restelli/current-controller/kicad/CurrentController.kicad_pcb

## KiCad design kicad/CurrentController.kicad_pcb (2024-09-20)

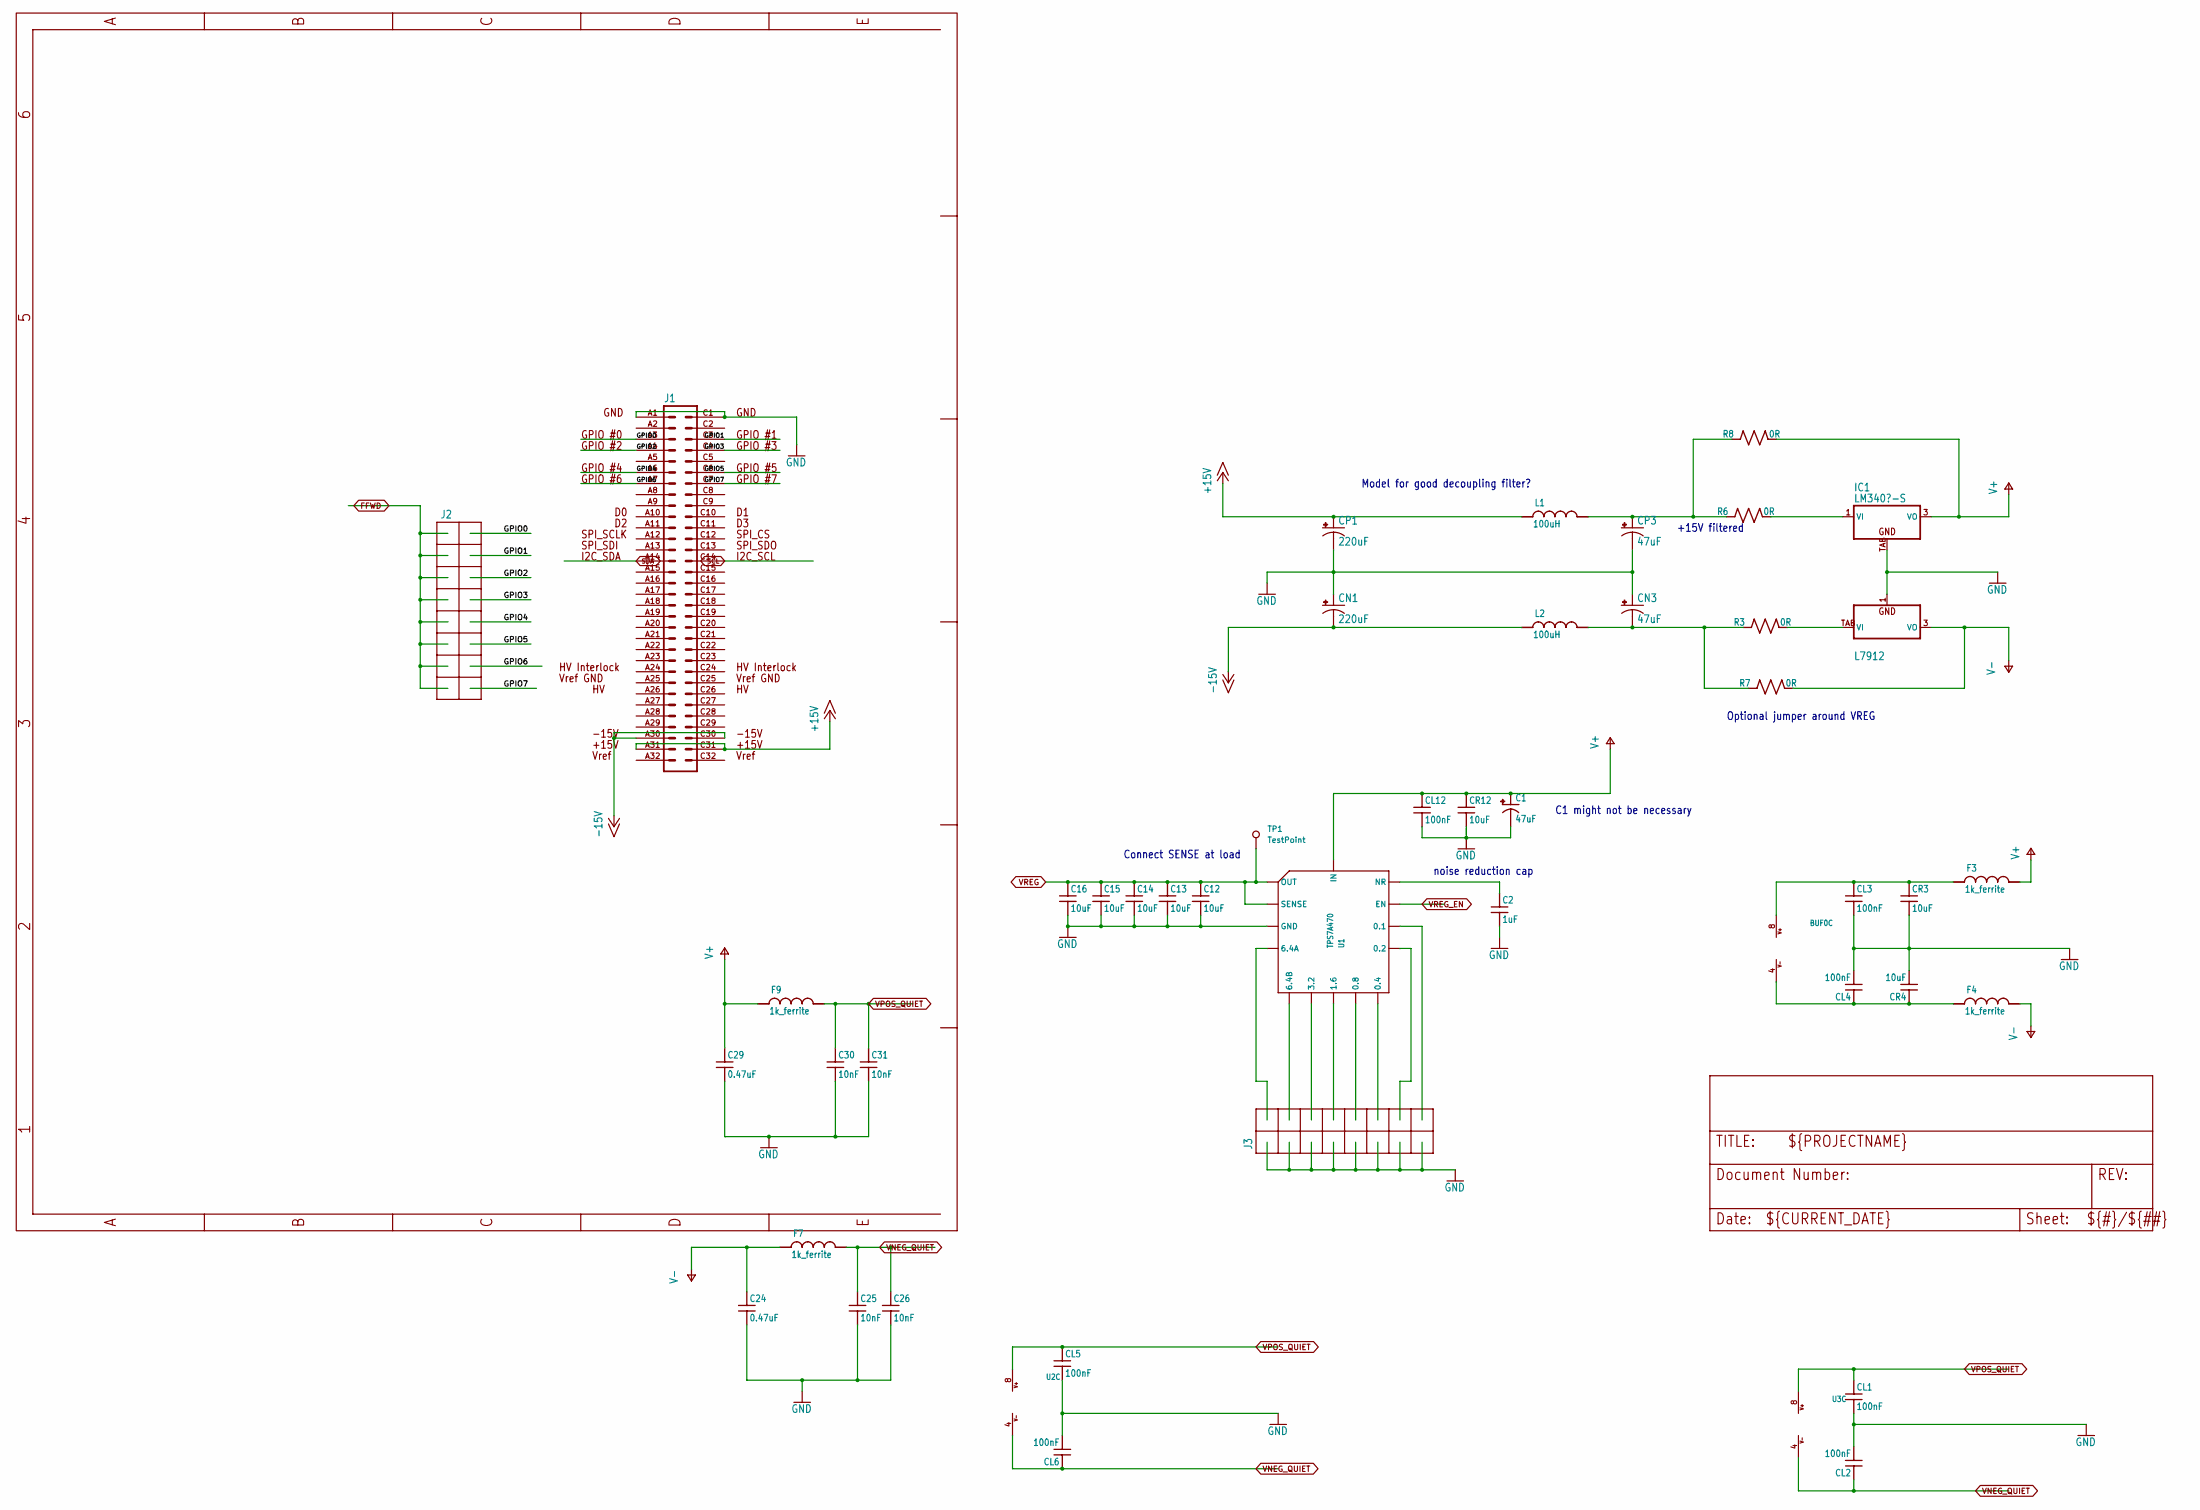
[picture p1: schematic CurrentController_1.kicad_sch]

Parts:
BUF0: AD8676; MSOP08; PARTNO AD8676ARMZ
C1: 47uF; C_POL_1206
C2: 1uF; C_MLCC_0603; PARTNO CL10B105KA8NNNC
C12, C13, C14, C15, C16: 10uF; C_MLCC_0805; PARTNO CL21A106KAFN3NE
C24, C29: 0.47uF; C_MLCC_0612; PARTNO LLL31MR71E474MA01L
C25, C26, C30, C31: 10nF; C_MLCC_0306; PARTNO 03063C103KAT2A
CL1, CL2, CL3, CL4, CL5, CL6, CL12: 100nF; C_MLCC_0603; PARTNO C1608X7R1E104K080AA
CN1: 220uF; PANASONIC_F; PARTNO EEE-1VA221UP
CN3: 47uF; CT7343; PARTNO T491D476M025AT
CP1: 220uF; PANASONIC_F; PARTNO EEE-1VA221UP
CP3: 47uF; CT7343; PARTNO T491D476M025AT
CR3, CR4, CR12: 10uF; C_MLCC_0805; PARTNO CL21A106KAFN3NE
F3, F4, F7, F9: 1k_ferrite; L_FERRITE_0603; PARTNO BLM18HG102SN1D
IC1: LM340?-S; TO263-3; PARTNO LM340S-12/NOPB
IC2: L7912; TO223-3; PARTNO MC7912CD2TG
J1: VG64C; VG64-CUTOUT; PARTNO 5650945-5
J2, J3: 2X8_LOW_PROFILE_JUMPER; 2X8_LOW_PROFILE_JUMPER_MATRIX; PARTNO A3B-16PA-2DSA(71)
L1, L2: 100uH; WURTH_1280; PARTNO 74477020
R3, R6, R7, R8: 0R; R_1206; PARTNO ERJ-8GEY0R00V
TP1: TestPoint; TestPoint_Pad_1.0x1.0mm
U1: TPS7A470; S-PVQFN-N20; PARTNO TPS7A4701RGWT
U2, U3: AD8676; MSOP08; PARTNO AD8676ARMZ

Connections:
+15V: CP1.+, J1.A31, J1.C31, L1.P$1 (1)
-15V: CN1.-, J1.A30, J1.C30, L2.P$1 (1)
/CurrentController_1/GPIO0: J1.A3, J2.P$2
/CurrentController_1/GPIO1: J1.C3, J2.P$4
/CurrentController_1/GPIO2: J1.A4, J2.P$6
/CurrentController_1/GPIO3: J1.C4, J2.P$8
/CurrentController_1/GPIO4: J1.A6, J2.P$10
/CurrentController_1/GPIO5: J1.C6, J2.P$12
/CurrentController_1/GPIO6: J1.A7, J2.P$14
/CurrentController_1/GPIO7: J1.C7, J2.P$16
FFWD: J2.P$1, J2.P$3, J2.P$5, J2.P$7, J2.P$9, J2.P$11, J2.P$13, J2.P$15; also elsewhere on the board
GND: C1.P$2 (-), C2.P$2 (2), C12.P$2 (2), C13.P$2 (2), C14.P$2 (2), C15.P$2 (2), C16.P$2 (2), C24.P$2 (2), C25.P$2 (2), C26.P$2 (2), C29.P$2 (2), C30.P$2 (2), C31.P$2 (2), CL1.P$2 (2), CL2.P$2 (2), CL3.P$2 (2), CL4.P$2 (2), CL5.P$2 (2), CL6.P$2 (2), CL12.P$2 (2), CN1.+, CN3.+, CP1.-, CP3.-, CR3.P$2 (2), CR4.P$2 (2), CR12.P$2 (2), IC1.TAB (GND), IC2.1 (GND), J1.A1, J1.C1, J3.P$1, J3.P$3, J3.P$5, J3.P$7, J3.P$9, J3.P$11, J3.P$13, J3.P$15, U1.2 (GND), U1.7 (GND), U1.17 (GND), U1.18 (GND), U1.19 (GND), U1.EXP (GND); also elsewhere on the board
unnamed: BUF0.8 (V+), CL3.P$1 (1), CR3.P$1 (1), F3.P$1 (1)
unnamed: BUF0.4 (V-), CL4.P$1 (1), CR4.P$1 (1), F4.P$1 (1)
unnamed: C2.P$1 (1), U1.14 (NR)
unnamed: IC1.1 (VI), R6.P$2 (2)
unnamed: IC2.TAB (VI), R3.P$2 (2)
unnamed: CP3.+, L1.P$2 (2), R6.P$1 (1), R8.P$1 (1)
unnamed: CN3.-, L2.P$2 (2), R3.P$1 (1), R7.P$1 (1)
unnamed: J3.P$16, U1.12 (0.1)
unnamed: J3.P$14, U1.11 (0.2)
unnamed: J3.P$12, U1.10 (0.4)
unnamed: J3.P$10, U1.9 (0.8)
unnamed: J3.P$8, U1.8 (1.6)
unnamed: J3.P$6, U1.6 (3.2)
unnamed: J3.P$2, U1.4 (6.4A)
unnamed: J3.P$4, U1.5 (6.4B)
SCL: J1.C14; also elsewhere on the board
SDA: J1.A14; also elsewhere on the board
V+: C1.P$1 (+), C29.P$1 (1), CL12.P$1 (1), CR12.P$1 (1), F3.P$2 (2), F9.P$1 (1), IC1.3 (VO), R8.P$2 (2), U1.15 (IN), U1.16 (IN); also elsewhere on the board
V-: C24.P$1 (1), F4.P$2 (2), F7.P$1 (1), IC2.3 (VO), R7.P$2 (2); also elsewhere on the board
VNEG_QUIET: C25.P$1 (1), C26.P$1 (1), CL2.P$1 (1), CL6.P$1 (1), F7.P$2 (2), U2.4 (V-), U3.4 (V-); also elsewhere on the board
VPOS_QUIET: C30.P$1 (1), C31.P$1 (1), CL1.P$1 (1), CL5.P$1 (1), F9.P$2 (2), U2.8 (V+), U3.8 (V+); also elsewhere on the board
VREG: C12.P$1 (1), C13.P$1 (1), C14.P$1 (1), C15.P$1 (1), C16.P$1 (1), TP1.1, U1.1 (OUT), U1.3 (SENSE), U1.20 (OUT); also elsewhere on the board
VREG_EN: U1.13 (EN); also elsewhere on the board

Notes on the sheet:
Optional jumper around VREG
C1 might not be necessary
Model for good decoupling filter?
+15V filtered
Connect SENSE at load
noise reduction cap

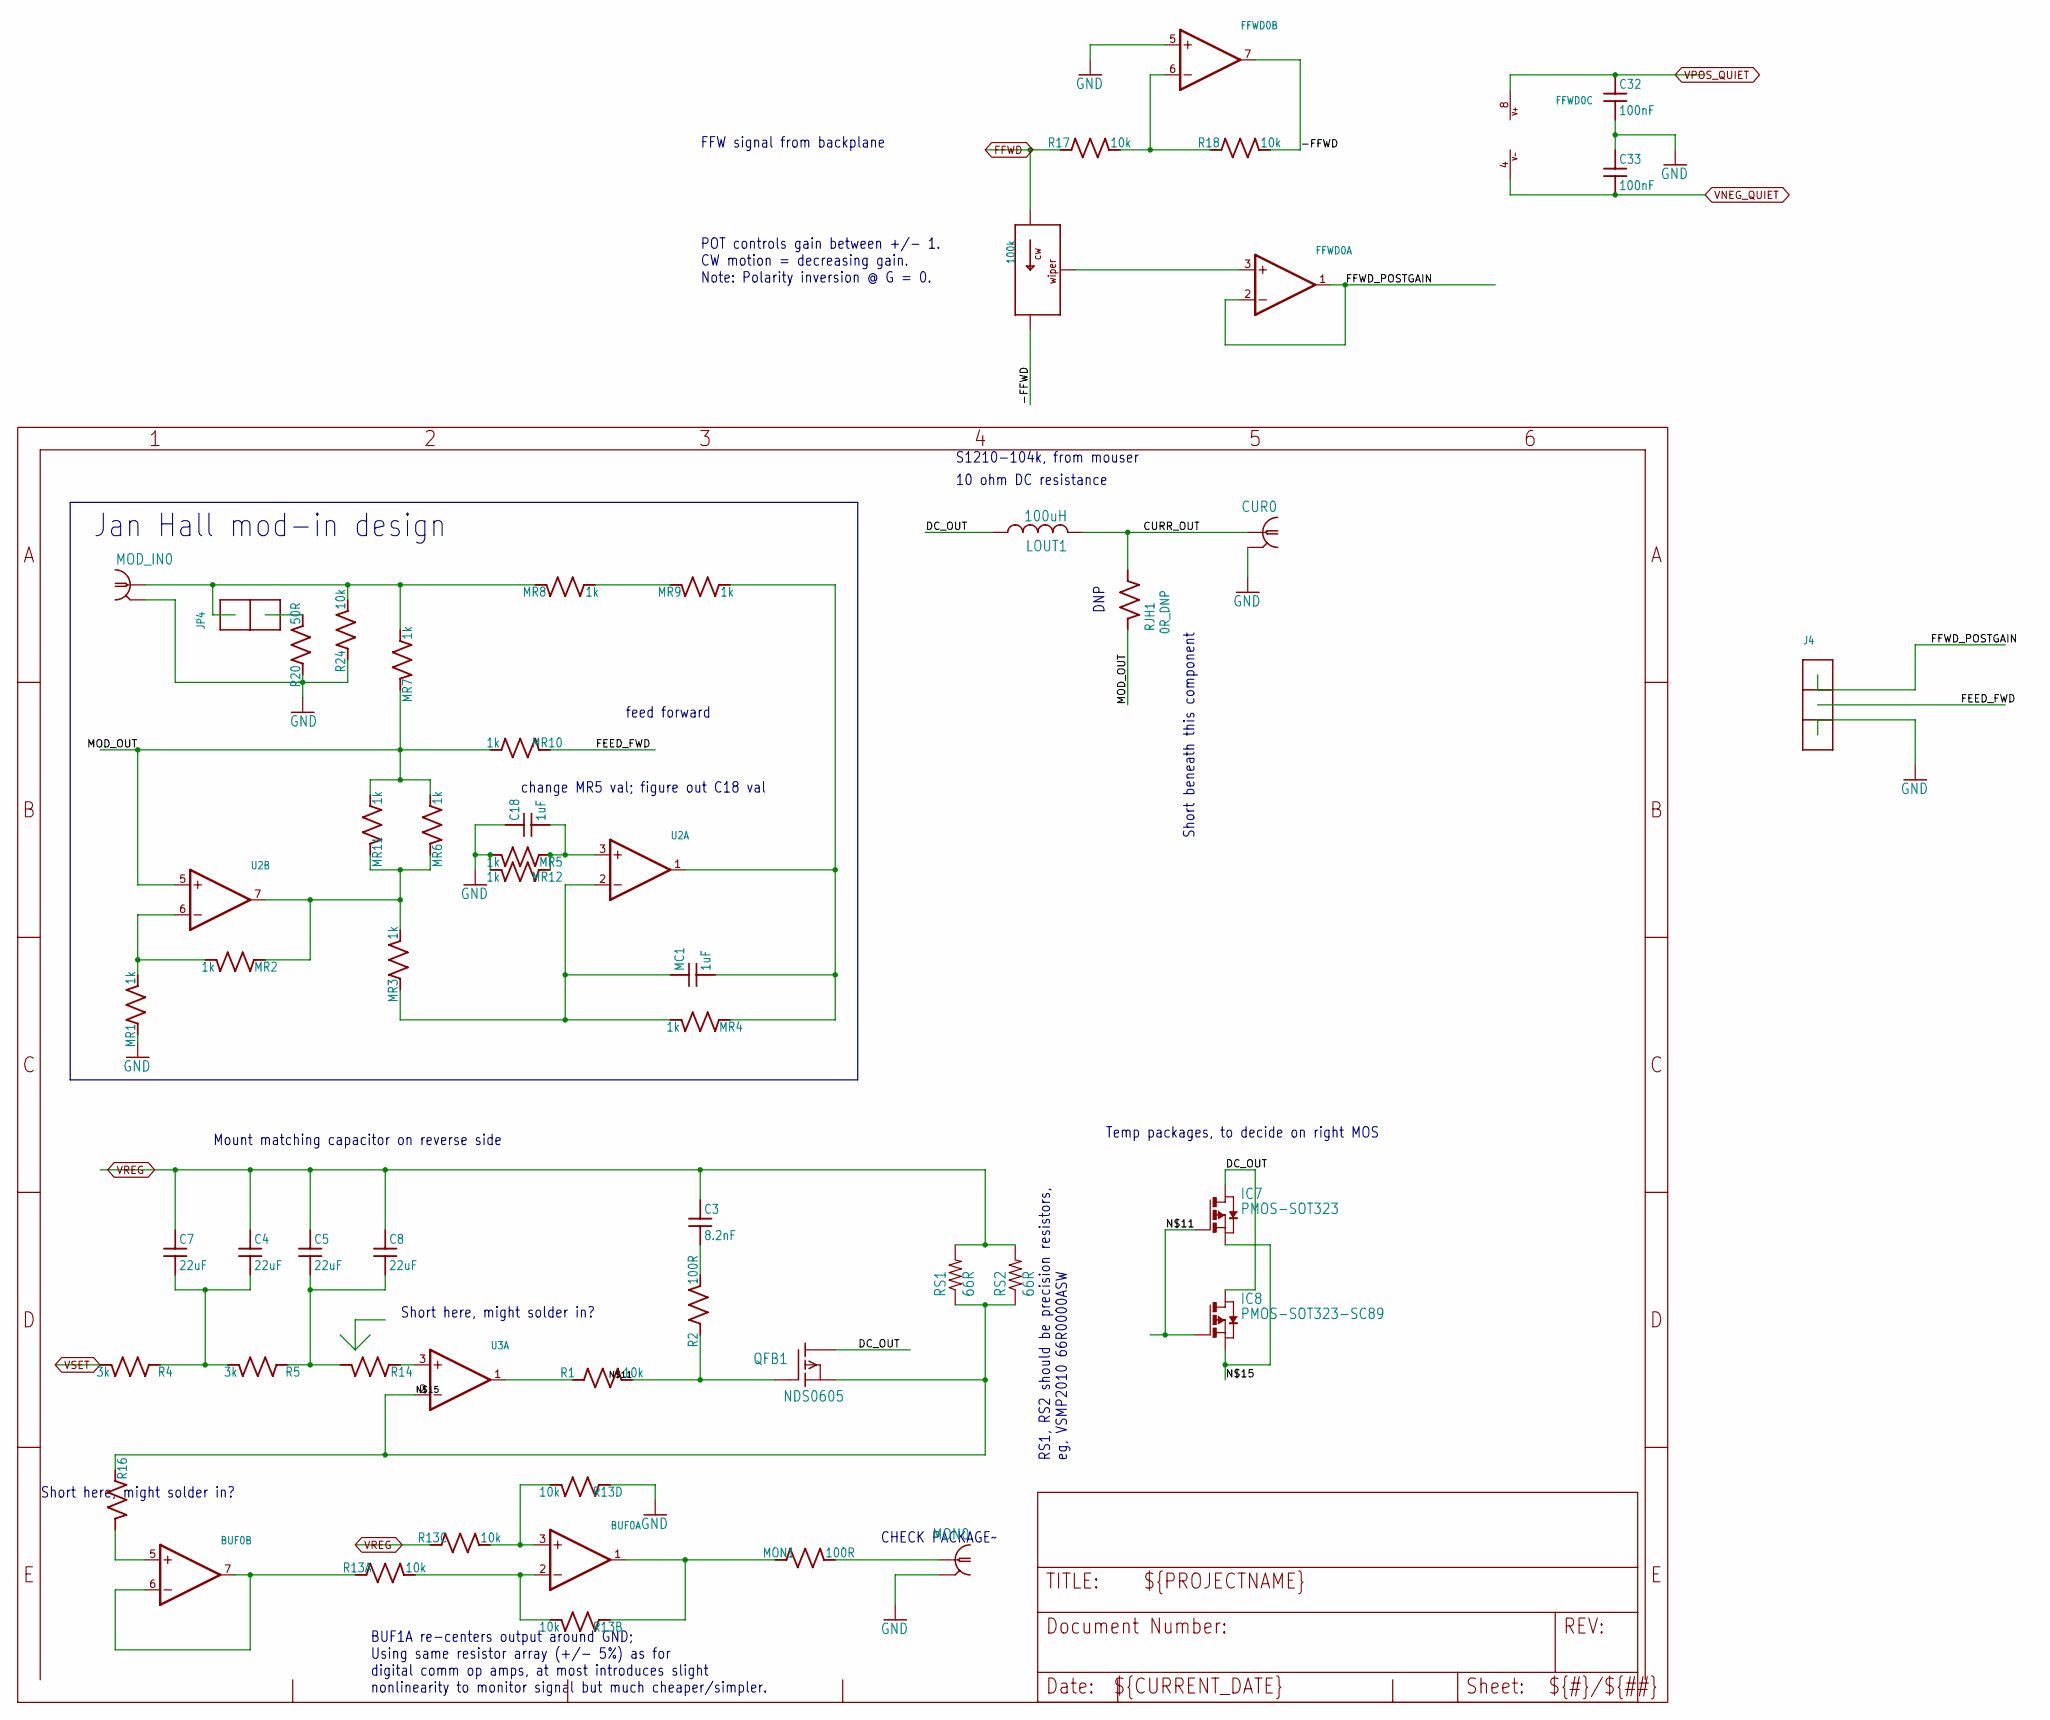
[picture p2: schematic CurrentController_2.kicad_sch]

Parts:
BUF0: AD8676; MSOP08; PARTNO AD8676ARMZ
C3: 8.2nF; C_MLCC_0603; PARTNO CL10B822KB8NNNC
C4, C5, C7, C8: 22uF; C_MLCC_0805; PARTNO C2012X5R1E226M125AC
C18: 1uF; C_MLCC_0603; PARTNO CL10B105KA8NNNC
C32, C33: 100nF; C_MLCC_0603; PARTNO C1608X7R1E104K080AA
CUR0: BNC-H; BNC90; PARTNO 5227161-7
FFWD0: AD8676; MSOP08; PARTNO AD8676ARMZ
IC7: PMOS-SOT323; SOT323
IC8: PMOS-SOT323-SC89; SC-89
J4: 1X3_LOW_PROFILE_JUMPER; 1X3_LOW_PROFILE; PARTNO NRPN031PAEN-RC
JP4: 1X2_LOW_PROFILE_JUMPER; 1X2_LOW_PROFILE; PARTNO NRPN021PAEN-RC
LOUT1: 100uH; L3225P; PARTNO CBC3225T680KR
MC1: 1uF; C_MLCC_0603; PARTNO CL10B105KA8NNNC
MOD_IN0: BNC-H; BNC90; PARTNO 5227161-7
MON0: UMC; PARTNO 1909763-1
MON1: 100R; R_0603; PARTNO ERJ-3EKF1000V
MR1, MR2, MR3, MR4, MR5, MR6, MR7, MR8, MR9, MR10, MR11, MR12: 1k; R_0805; PARTNO ERA-6ARB102V
QFB1: NDS0605; SOT-23; PARTNO *
R1, R17, R18, R24: 10k; R_0603; PARTNO ERJ-3EKF1002V
R2: 100R; R_0603; PARTNO ERJ-3EKF1000V
R4, R5: 3k; R_0603; PARTNO ERJ-3EKF3001V
R13: 10k; 742_ARRAY; PARTNO 742C083103JP
R14, R16: R_SMDR0603; R_0603
R20: 50R; R_0805; PARTNO ERJ-6ENF49R9V
RJH1: 0R_DNP; R_0603
RS1, RS2: 66R; R2010
T1: 100k; 3006P; PARTNO 3006P-1-104LF
U2, U3: AD8676; MSOP08; PARTNO AD8676ARMZ

Connections:
/CurrentController_2/-FFWD: FFWD0.7 (OUT), R18.P$2 (2), T1.P$3
/CurrentController_2/CURR_OUT: CUR0.1, LOUT1.2, RJH1.P$1 (1)
/CurrentController_2/DC_OUT: IC7.3 (D), IC8.P$3 (D), LOUT1.1, QFB1.3 (D)
/CurrentController_2/FEED_FWD: J4.P2, MR10.P$1 (1)
/CurrentController_2/FFWD_POSTGAIN: FFWD0.1 (OUT), FFWD0.2 (-IN), J4.P1
/CurrentController_2/MOD_OUT: MR6.P$2 (2), MR7.P$1 (1), MR10.P$2 (2), MR11.P$2 (2), RJH1.P$2 (2), U2.5 (+IN)
/CurrentController_2/N$11: IC7.1 (G), IC8.P$1 (G), QFB1.1 (G), R1.P$2 (2), R2.P$1 (1)
/CurrentController_2/N$15: IC7.2 (S), IC8.P$2 (S), QFB1.2 (S), R16.P$1 (1), RS1.1, RS2.1, U3.2 (-IN)
FFWD: R17.P$1 (1), T1.P$1; also elsewhere on the board
GND: C18.P$1 (1), C32.P$2 (2), C33.P$1 (1), CUR0.2, FFWD0.5 (+IN), J4.P3, MOD_IN0.2, MON0.P$2 (2), MON0.P$3 (2), MR1.P$1 (1), MR5.P$2 (2), MR12.P$2 (2), R13.P$7 (1), R20.P$1 (1), R24.P$1 (1); also elsewhere on the board
unnamed: BUF0.3 (+IN), R13.P$6 (2), R13.P$8 (2)
unnamed: BUF0.2 (-IN), R13.P$2 (2), R13.P$4 (2)
unnamed: BUF0.1 (OUT), MON1.P$1 (1), R13.P$3 (1)
unnamed: BUF0.5 (+IN), R16.P$2 (2)
unnamed: BUF0.6 (-IN), BUF0.7 (OUT), R13.P$1 (1)
unnamed: C3.P$2 (2), R2.P$2 (2)
unnamed: C4.P$2 (2), C7.P$2 (2), R4.P$1 (1), R5.P$2 (2)
unnamed: C5.P$2 (2), C8.P$2 (2), R5.P$1 (1), R14.P$2 (2)
unnamed: C18.P$2 (2), MR5.P$1 (1), MR12.P$1 (1), U2.3 (+IN)
unnamed: FFWD0.3 (+IN), T1.P$2
unnamed: FFWD0.6 (-IN), R17.P$2 (2), R18.P$1 (1)
unnamed: JP4.1, MOD_IN0.1, MR7.P$2 (2), MR8.P$1 (1), R24.P$2 (2)
unnamed: JP4.2, R20.P$2 (2)
unnamed: MC1.P$1 (1), MR3.P$1 (1), MR4.P$2 (2), U2.2 (-IN)
unnamed: MC1.P$2 (2), MR4.P$1 (1), MR9.P$2 (2), U2.1 (OUT)
unnamed: MON0.P$1 (1), MON1.P$2 (2)
unnamed: MR1.P$2 (2), MR2.P$2 (2), U2.6 (-IN)
unnamed: MR8.P$2 (2), MR9.P$1 (1)
unnamed: MR2.P$1 (1), MR3.P$2 (2), MR6.P$1 (1), MR11.P$1 (1), U2.7 (OUT)
unnamed: R1.P$1 (1), U3.1 (OUT)
unnamed: R14.P$1 (1), U3.3 (+IN)
VNEG_QUIET: C33.P$2 (2), FFWD0.4 (V-); also elsewhere on the board
VPOS_QUIET: C32.P$1 (1), FFWD0.8 (V+); also elsewhere on the board
VREG: C3.P$1 (1), C4.P$1 (1), C5.P$1 (1), C7.P$1 (1), C8.P$1 (1), R13.P$5 (1), RS1.2, RS2.2; also elsewhere on the board
VSET: R4.P$2 (2); also elsewhere on the board

Notes on the sheet:
change MR5 val; figure out C18 val
CHECK PACKAGE~
S1210-104k, from mouser
Jan Hall mod-in design
Short beneath this component
POT controls gain between +/- 1. CW motion = decreasing gain. Note: Polarity inversion @ G = 0.
FFW signal from backplane
10 ohm DC resistance
DNP
RS1, RS2 should be precision resistors, eg, VSMP2010 66R0000ASW
feed forward
Short here, might solder in?
Mount matching capacitor on reverse side
Temp packages, to decide on right MOS
BUF1A re-centers output around GND; Using same resistor array (+/- 5%) as for digital comm op amps, at most introduces slight nonlinearity to monitor signal but much cheaper/simpler.

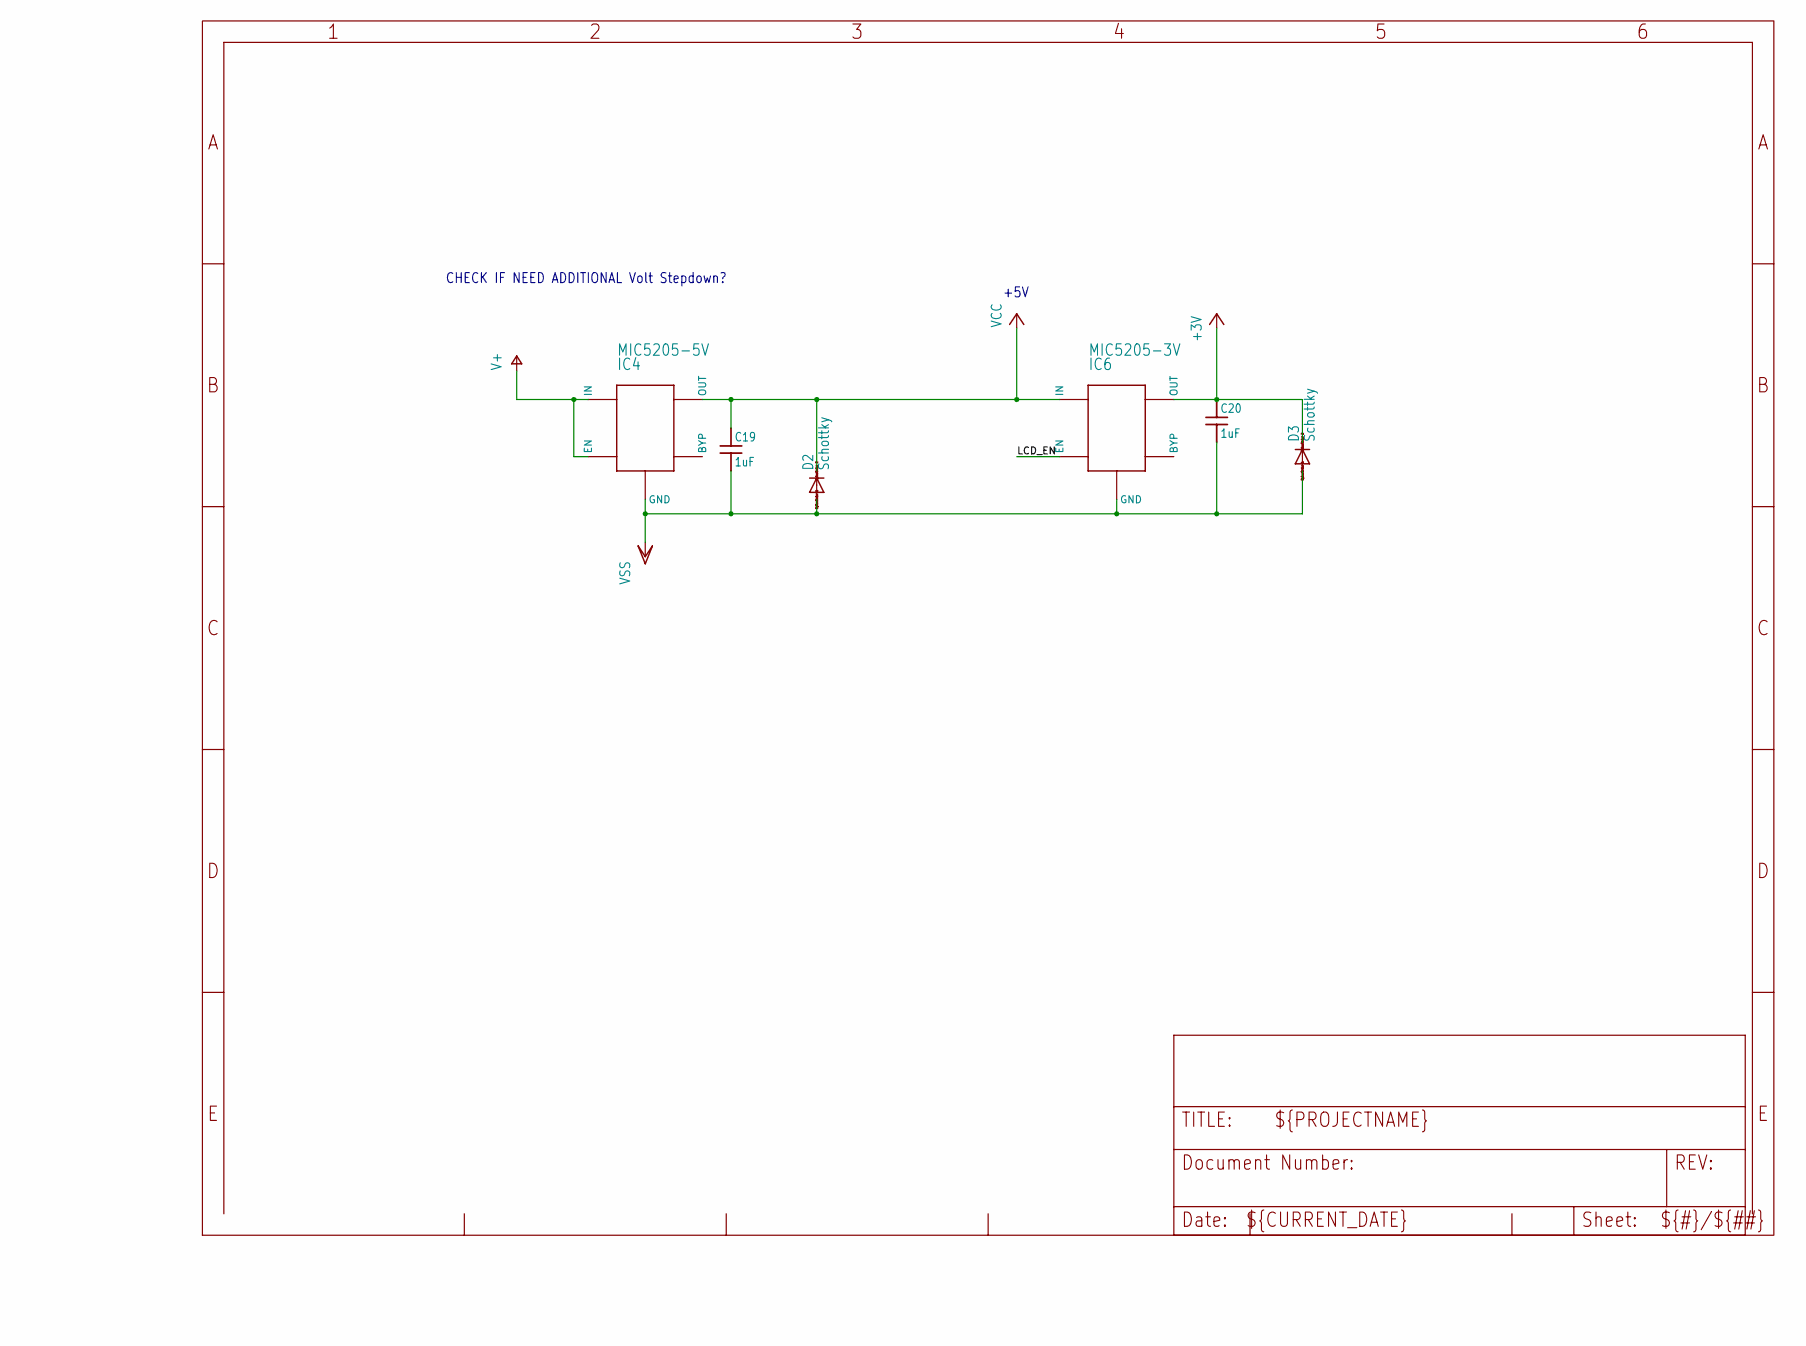
[picture p3: schematic CurrentController_4.kicad_sch, part in row 1, column 2]

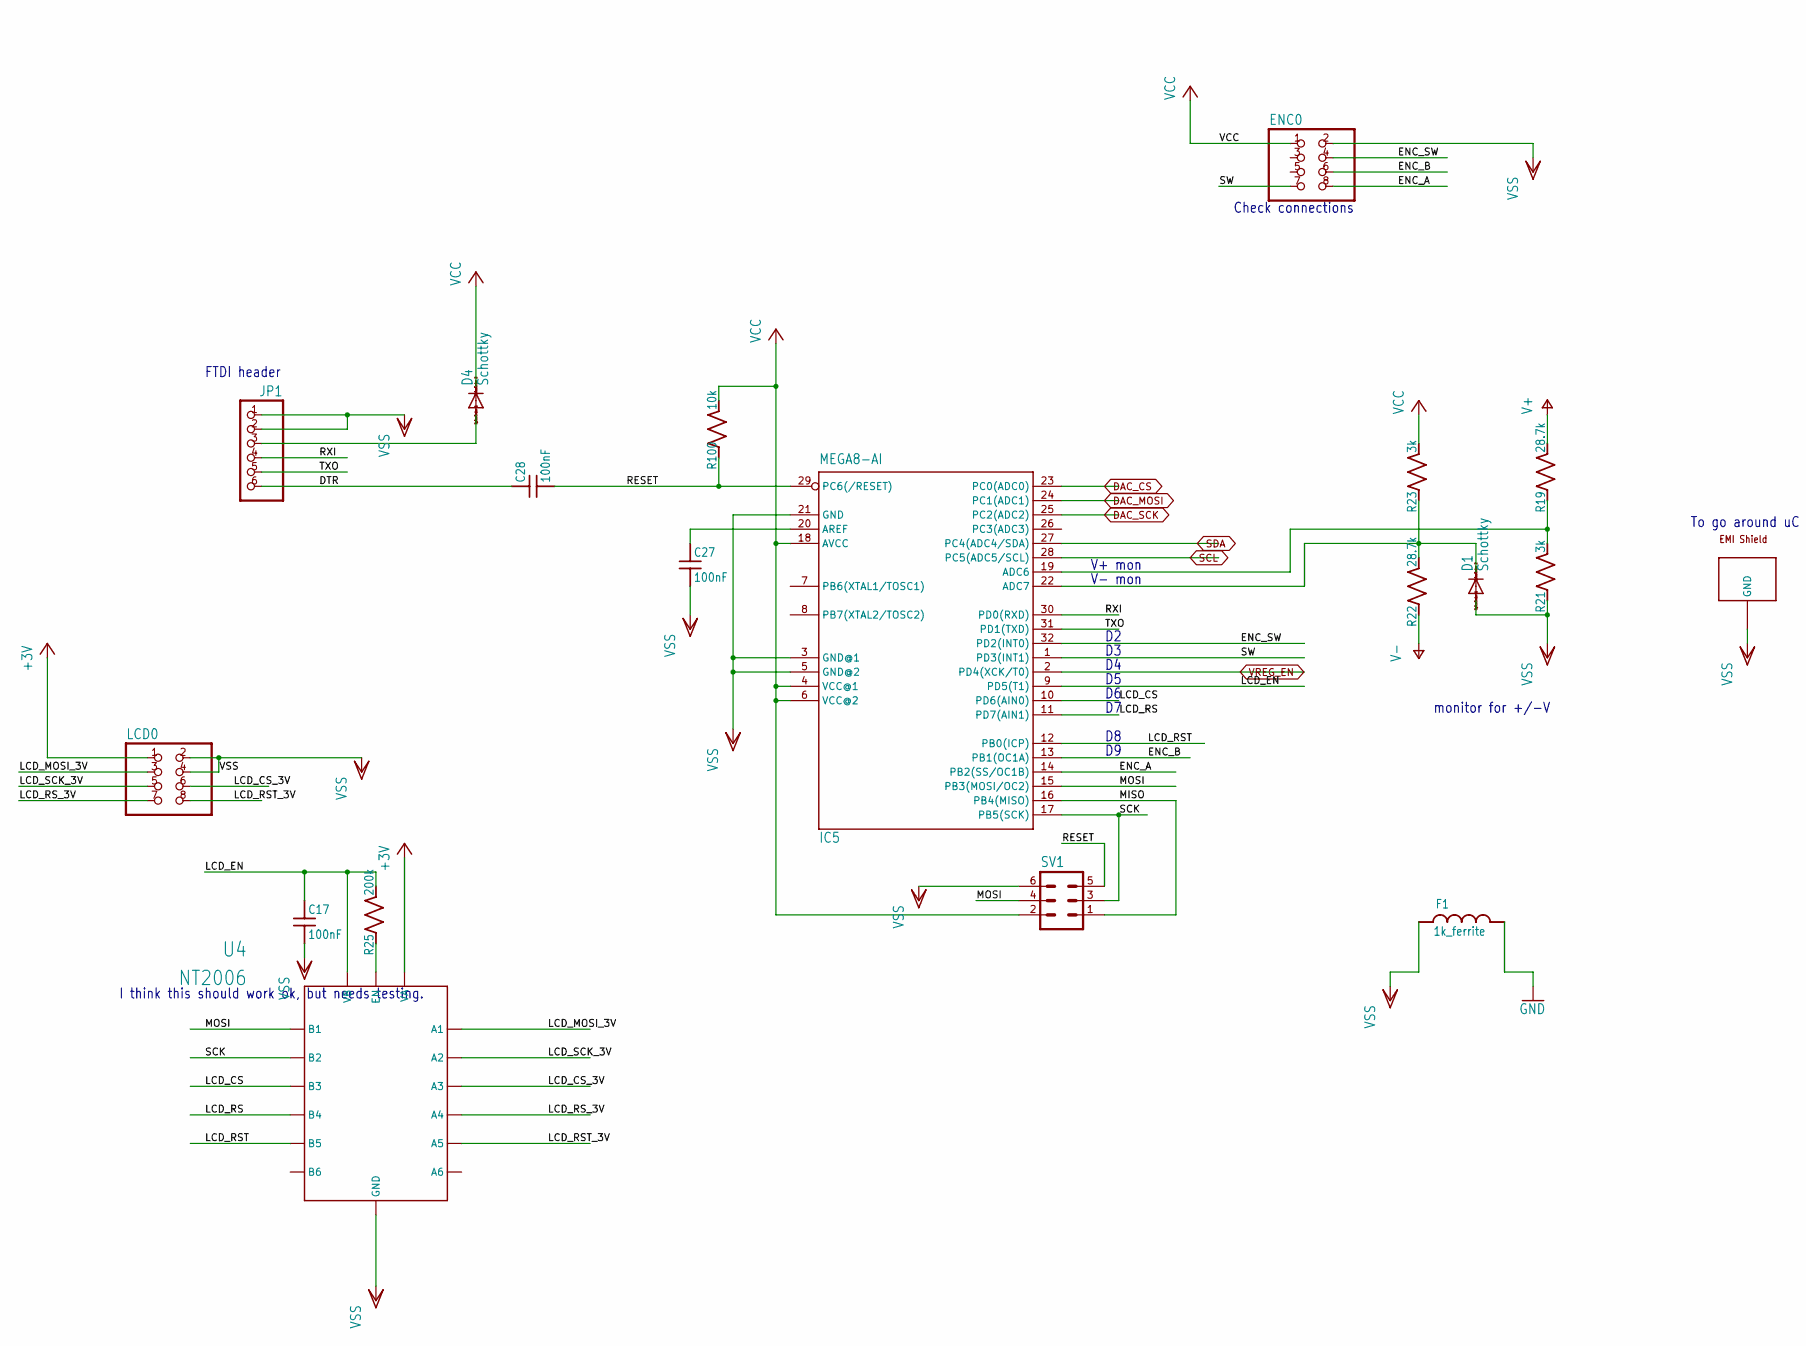
[picture p4: schematic CurrentController_4.kicad_sch, part in row 2, column 1]

Parts:
C17, C27, C28: 100nF; C_MLCC_0603; PARTNO C1608X7R1E104K080AA
C19, C20: 1uF; C_MLCC_0603; PARTNO CL10B105KA8NNNC
D1, D2, D3, D4: Schottky; SOD523; PARTNO PMEG3005EB,115
ENC0: PINHD-2X4-SHROUD; ML08; PARTNO 75869-132LF
F1: 1k_ferrite; L_FERRITE_0603; PARTNO BLM18HG102SN1D
IC4: MIC5205-5V; SOT23-5L; PARTNO MIC5205-5.0YM5-TR
IC5: MEGA8-AI; TQFP32-08; PARTNO ATMEGA328P-AU
IC6: MIC5205-3V; SOT23-5L; PARTNO MIC5205-3.0YM5-TR
JP1: PINHD-1X6; 1X06; PARTNO 68000-406HLF
LCD0: PINHD-2X4-SHROUD; ML08; PARTNO 75869-132LF
R19, R22: 28.7k; R_0603; PARTNO ERJ-3EKF2872V
R21, R23: 3k; R_0603; PARTNO ERJ-3EKF3001V
R25: 200k; R_0603; PARTNO ERJ-3EKF2003V
R100: 10k; R_0603; PARTNO ERJ-3EKF1002V
SV1: MA03-2; PARTNO 67996-406HLF
U4: NT2006; HVQFN16; PARTNO NVT2006BS,118
U$5: WURTH_EMI; WURTH_SHIELD; PARTNO 36103205

Connections:
+3V: C20.P$1 (1), D3.C, IC6.5 (OUT), LCD0.1, U4.16 (VA)
/CurrentController_4/DTR: C28.P$1 (1), JP1.6
/CurrentController_4/ENC_A: ENC0.8, IC5.14 (PB2(SS/OC1B))
/CurrentController_4/ENC_B: ENC0.6, IC5.13 (PB1(OC1A))
/CurrentController_4/ENC_SW: ENC0.4, IC5.32 (PD2(INT0))
/CurrentController_4/LCD_CS: IC5.10 (PD6(AIN0)), U4.10 (B3)
/CurrentController_4/LCD_CS_3V: LCD0.6, U4.3 (A3)
/CurrentController_4/LCD_EN: C17.P$1 (1), IC5.9 (PD5(T1)), IC6.3 (EN), R25.P$2 (2), U4.13 (VB)
/CurrentController_4/LCD_MOSI_3V: LCD0.3, U4.1 (A1)
/CurrentController_4/LCD_RS: IC5.11 (PD7(AIN1)), U4.9 (B4)
/CurrentController_4/LCD_RST: IC5.12 (PB0(ICP)), U4.8 (B5)
/CurrentController_4/LCD_RST_3V: LCD0.8, U4.5 (A5)
/CurrentController_4/LCD_RS_3V: LCD0.7, U4.4 (A4)
/CurrentController_4/LCD_SCK_3V: LCD0.5, U4.2 (A2)
/CurrentController_4/MISO: IC5.16 (PB4(MISO)), SV1.1
/CurrentController_4/MOSI: IC5.15 (PB3(MOSI/OC2)), SV1.4, U4.12 (B1)
/CurrentController_4/RESET: C28.P$2 (2), IC5.29 (PC6(/RESET)), R100.P$1 (1), SV1.5
/CurrentController_4/RXI: IC5.30 (PD0(RXD)), JP1.4
/CurrentController_4/SCK: IC5.17 (PB5(SCK)), SV1.3, U4.11 (B2)
/CurrentController_4/SW: ENC0.7, IC5.1 (PD3(INT1))
/CurrentController_4/TXO: IC5.31 (PD1(TXD)), JP1.5
DAC_CS: IC5.23 (PC0(ADC0)); also elsewhere on the board
DAC_MOSI: IC5.24 (PC1(ADC1)); also elsewhere on the board
DAC_SCK: IC5.25 (PC2(ADC2)); also elsewhere on the board
GND: F1.P$2 (2); also elsewhere on the board
unnamed: C27.P$1 (1), IC5.20 (AREF)
unnamed: D4.A, JP1.3
unnamed: IC5.19 (ADC6), R19.P$1 (1), R21.P$2 (2)
unnamed: D1.C, IC5.22 (ADC7), R22.P$2 (2), R23.P$1 (1)
unnamed: R25.P$1 (1), U4.14 (EN)
SCL: IC5.28 (PC5(ADC5/SCL)); also elsewhere on the board
SDA: IC5.27 (PC4(ADC4/SDA)); also elsewhere on the board
V+: IC4.1 (IN), IC4.3 (EN), R19.P$2 (2); also elsewhere on the board
V-: R22.P$1 (1); also elsewhere on the board
VCC: C19.P$1 (1), D2.C, D4.C, ENC0.1, IC4.5 (OUT), IC5.4 (VCC@1), IC5.6 (VCC@2), IC5.18 (AVCC), IC6.1 (IN), R23.P$2 (2), R100.P$2 (2), SV1.2
VREG_EN: IC5.2 (PD4(XCK/T0)); also elsewhere on the board
VSS: C17.P$2 (2), C19.P$2 (2), C20.P$2 (2), C27.P$2 (2), D1.A, D2.A, D3.A, ENC0.2, F1.P$1 (1), IC4.2 (GND), IC5.3 (GND@1), IC5.5 (GND@2), IC5.21 (GND), IC6.2 (GND), JP1.1, JP1.2, LCD0.2, LCD0.4, R21.P$1 (1), SV1.6, U4.15 (GND), U4.P$17 (GND), U$5.P$1 (GND), U$5.P$2 (GND), U$5.P$3 (GND), U$5.P$4 (GND), U$5.P$5 (GND), U$5.P$6 (GND), U$5.P$7 (GND), U$5.P$8 (GND), U$5.P$9 (GND), U$5.P$10 (GND), U$5.P$11 (GND), U$5.P$12 (GND), U$5.P$13 (GND), U$5.P$14 (GND), U$5.P$15 (GND), U$5.P$16 (GND)

Notes on the sheet:
Check connections
monitor for +/-V
CHECK IF NEED ADDITIONAL Volt Stepdown?
V- mon
To go around uC
+5V
I think this should work ok, but needs testing.
V+ mon
FTDI header

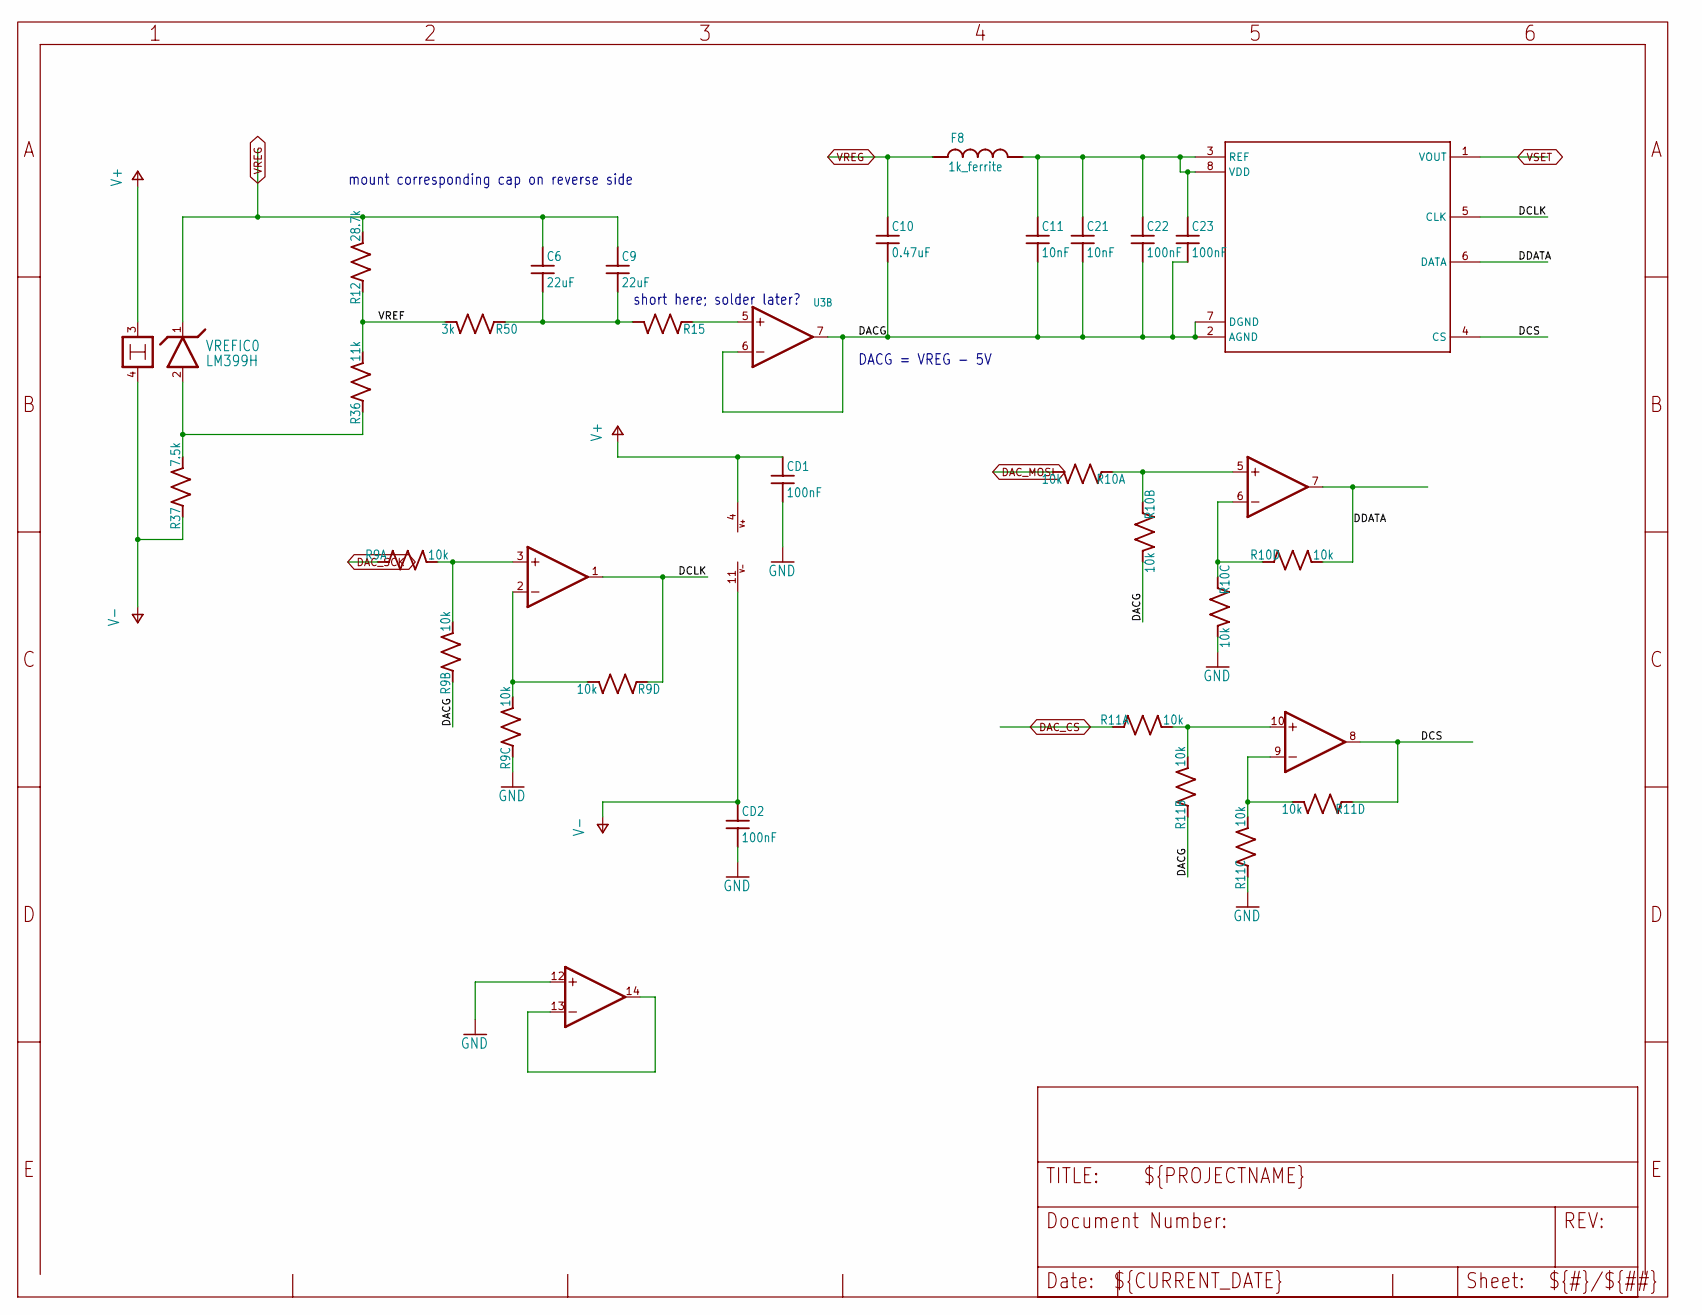
[picture p5: schematic CurrentController_3.kicad_sch]

Parts:
C6, C9: 22uF; C_MLCC_0805; PARTNO C2012X5R1E226M125AC
C10: 0.47uF; C_MLCC_0612; PARTNO LLL31MR71E474MA01L
C11, C21: 10nF; C_MLCC_0306; PARTNO 03063C103KAT2A
C22, C23: 100nF; C_MLCC_0603; PARTNO C1608X7R1E104K080AA
CD1, CD2: 100nF; C_MLCC_0603; PARTNO C1608X7R1E104K080AA
DAC1: AD5541; SOIC-8; PARTNO AD5541BRZ
F8: 1k_ferrite; L_FERRITE_0603; PARTNO BLM18HG102SN1D
IC3: TS514; SO14; PARTNO TS514AIDT
R9, R10, R11: 10k; 742_ARRAY; PARTNO 742C083103JP
R12: 28.7k; R_0603; PARTNO ERJ-3EKF2872V
R15: R_SMDR0603; R_0603
R36: 11k; R_0603; PARTNO ERJ-3EKF1102V
R37: 7.5k; R_0603; PARTNO ERJ-3EKF7501V
R50: 3k; R_0603; PARTNO ERJ-3EKF3001V
U3: AD8676; MSOP08; PARTNO AD8676ARMZ
VREFIC0: LM399H; TO39_4; PARTNO LM399H#PBF

Connections:
/CurrentController_3/DACG: C10.P$2 (2), C11.P$2 (2), C21.P$2 (2), C22.P$2 (2), C23.P$2 (2), DAC1.2 (AGND), DAC1.7 (DGND), R9.P$3 (1), R10.P$4 (2), R11.P$3 (1), U3.6 (-IN), U3.7 (OUT)
/CurrentController_3/DCLK: DAC1.5 (CLK), IC3.1 (OUT), R9.P$7 (1)
/CurrentController_3/DCS: DAC1.4 (CS), IC3.8 (OUT), R11.P$7 (1)
/CurrentController_3/DDATA: DAC1.6 (DATA), IC3.7 (OUT), R10.P$8 (2)
/CurrentController_3/VREF: R12.P$1 (1), R36.P$2 (2), R50.P$2 (2)
DAC_CS: R11.P$1 (1); also elsewhere on the board
DAC_MOSI: R10.P$2 (2); also elsewhere on the board
DAC_SCK: R9.P$1 (1); also elsewhere on the board
GND: CD1.P$2 (2), CD2.P$2 (2), IC3.12 (+IN), R9.P$5 (1), R10.P$6 (2), R11.P$5 (1); also elsewhere on the board
unnamed: C6.P$2 (2), C9.P$2 (2), R15.P$2 (2), R50.P$1 (1)
unnamed: C11.P$1 (1), C21.P$1 (1), C22.P$1 (1), C23.P$1 (1), DAC1.3 (REF), DAC1.8 (VDD), F8.P$2 (2)
unnamed: IC3.3 (+IN), R9.P$2 (2), R9.P$4 (2)
unnamed: IC3.2 (-IN), R9.P$6 (2), R9.P$8 (2)
unnamed: IC3.5 (+IN), R10.P$1 (1), R10.P$3 (1)
unnamed: IC3.6 (-IN), R10.P$5 (1), R10.P$7 (1)
unnamed: IC3.10 (+IN), R11.P$2 (2), R11.P$4 (2)
unnamed: IC3.9 (-IN), R11.P$6 (2), R11.P$8 (2)
unnamed: IC3.13 (-IN), IC3.14 (OUT)
unnamed: R15.P$1 (1), U3.5 (+IN)
unnamed: R36.P$1 (1), R37.P$2 (2), VREFIC0.2
V+: CD1.P$1 (1), IC3.4 (V+), VREFIC0.3; also elsewhere on the board
V-: CD2.P$1 (1), IC3.11 (V-), R37.P$1 (1), VREFIC0.4; also elsewhere on the board
VREG: C6.P$1 (1), C9.P$1 (1), C10.P$1 (1), F8.P$1 (1), R12.P$2 (2), VREFIC0.1; also elsewhere on the board
VSET: DAC1.1 (VOUT); also elsewhere on the board

Notes on the sheet:
DACG = VREG - 5V
short here; solder later?
mount corresponding cap on reverse side
