restelli/current-controller/kicad/CurrentController.kicad_pcb

## KiCad design kicad/CurrentController.kicad_pcb (continued)

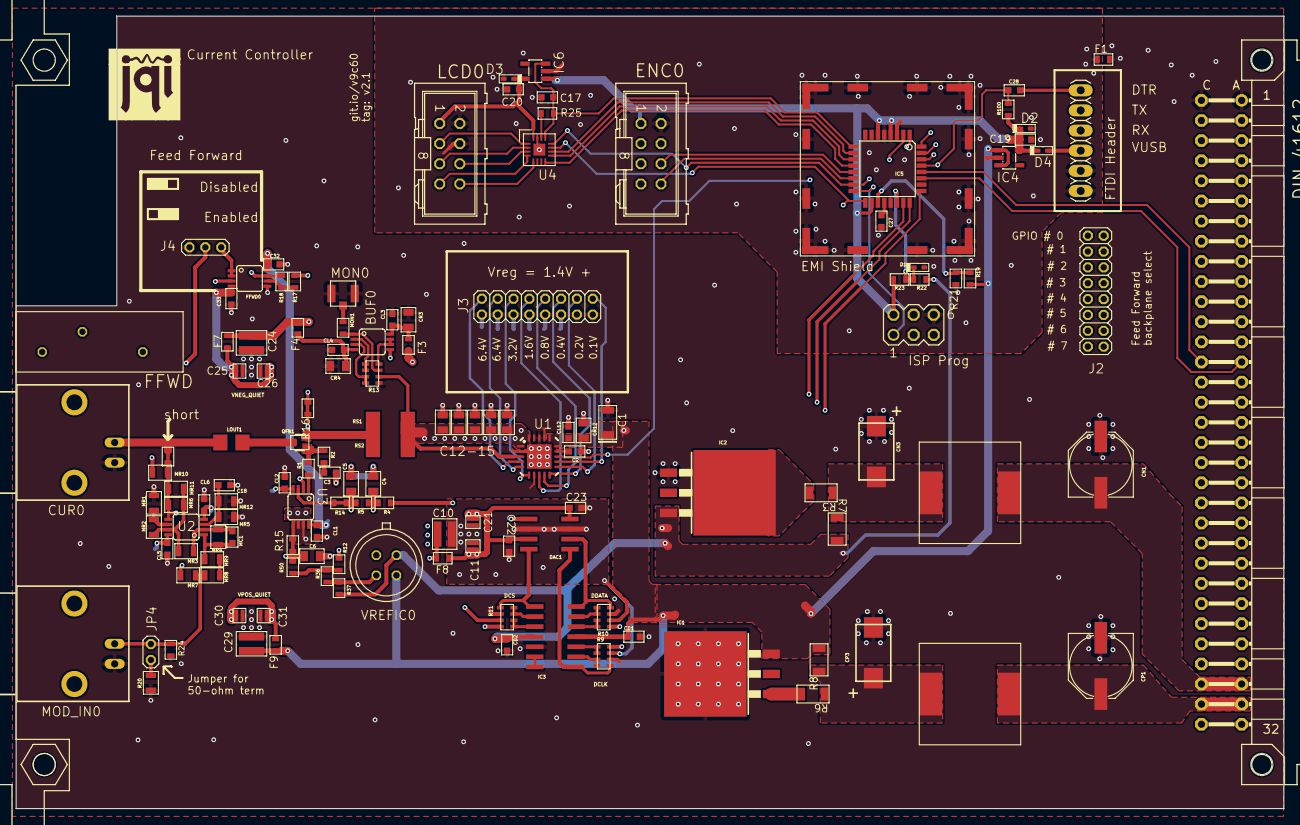
[picture p6: board CurrentController.kicad_pcb from above]

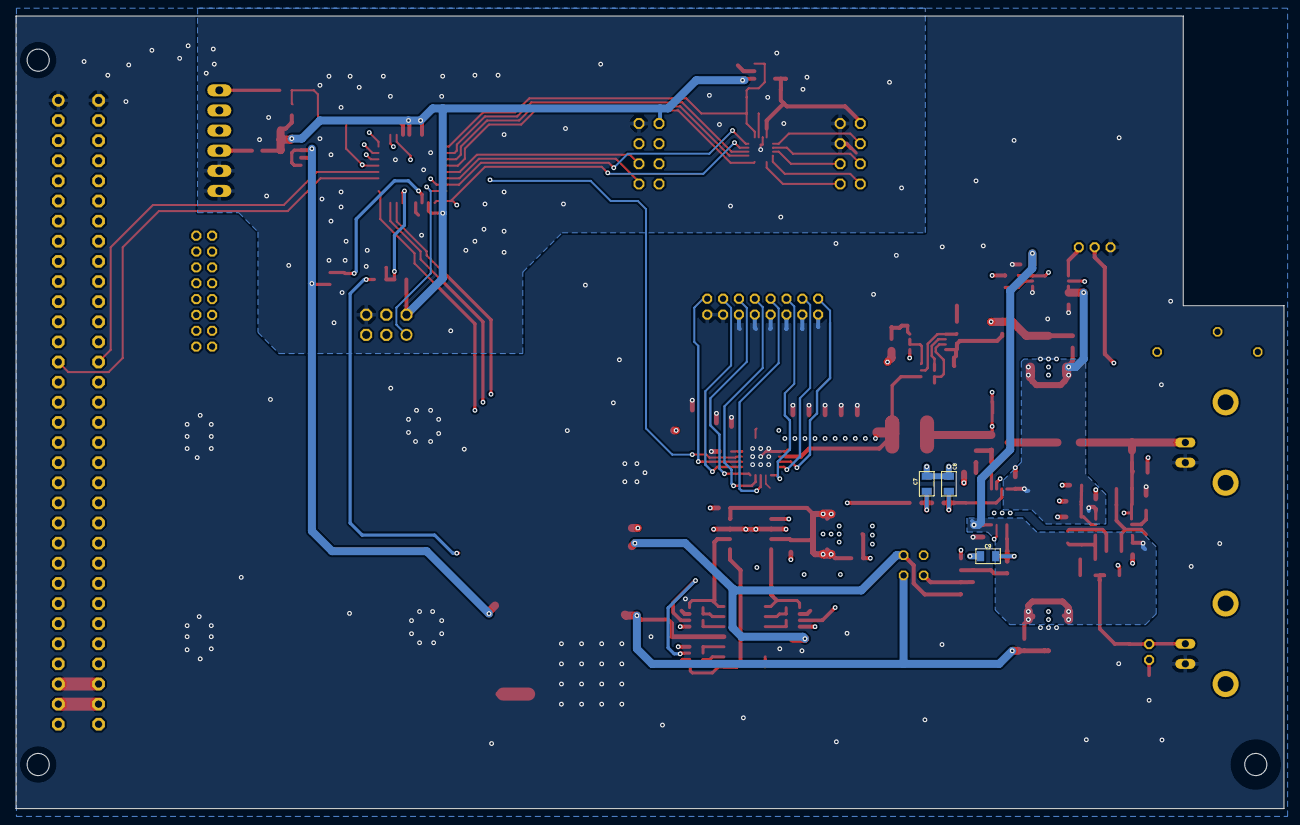
[picture p7: board CurrentController.kicad_pcb from below]

Board: 4 copper layers, 160.0 x 100.0 mm, 139 parts (3 on the bottom side), 112 nets.
